flukso/knixx-go/pcb/Knixx_Thunder_00_frontplate_cassini.dxf

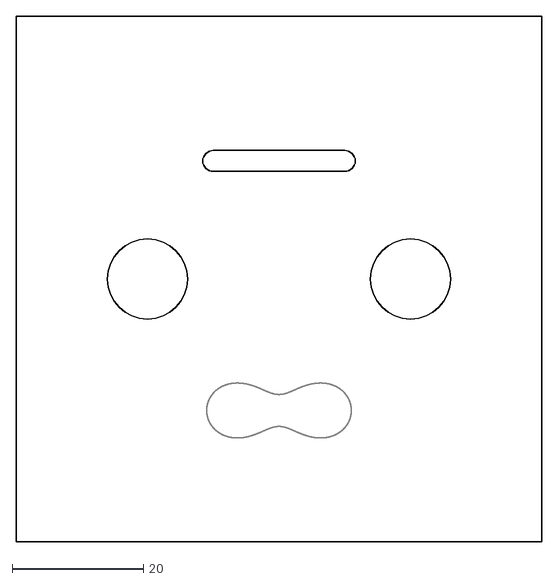
[picture p5: CAD file, 2026-10-24, last stored version]
pcb/Knixx_Thunder_00_frontplate_cassini.dxf
80.0 x 80.0
