flukso/knixx-go/pcb/Knixx_Thunder_00_sampler.dxf

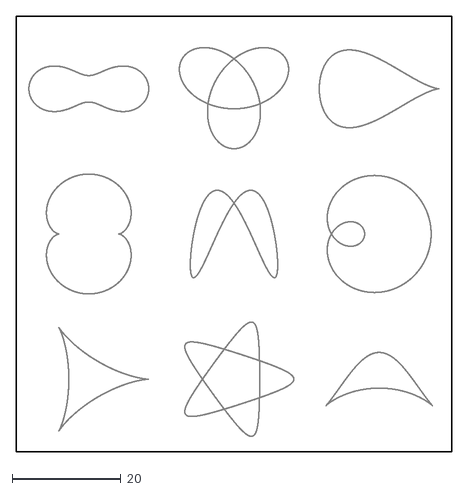
[picture p15: CAD file, 2026-10-24, last stored version]
pcb/Knixx_Thunder_00_sampler.dxf
80.0 x 80.0
