flukso/knixx-go/pcb/Knixx_Thunder_00_frontplate.step

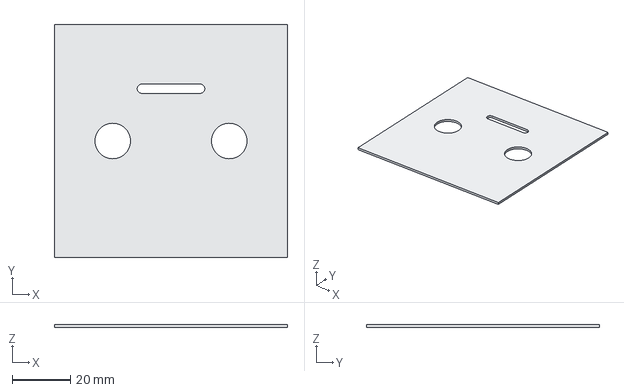
[picture p20: CAD file, 2026-10-23, last stored version]
pcb/Knixx_Thunder_00_frontplate.step
80.0 x 80.0 x 1.00 mm
