flukso/knixx-go/(list of files, cad)

Other CAD files:
pcb/Knixx_Thunder_00_frontplate.dxf
