flukso/knixx-go/(commit log)

2026-10-13 [ftdi|light|config|ncn] ini-configured switches with interactive shell
    Load the device's individual address and the group addresses of
    switches A and B from knixx.ini. An ishell prompt accepts
    "switch <A|B> <on|off>" and queues commands on a buffered channel for a
    separate goroutine that transmits the telegrams. "sniff <on|off>"
    toggles the hex dump of bus traffic, off by default.
    ncn.TxData now returns write errors.
2026-10-14 [ncn|ftdi] stat command and decoding of NCN5121 indications
    Add a "stat" shell command that queries U_State and U_SystemStat and
    prints both decoded. With sniff on, indications in the RX stream
    (L_Data.con, U_State.ind, U_FrameState.ind, U_Reset.ind) are decoded
    below the hex dump; frame octets are skipped so they aren't mistaken for
    services. ncn.TxData now sends a frame in a single write.
2026-10-16 [nrf|bus|cli|config] port the switch to the Feather nRF52840
    Run the KNX switch on the Feather nRF52840 Express. At startup the
    firmware mounts littlefs on the external SPI flash, formatting it and
    writing a default knixx.ini when none is found, and serves the switch,
    sniff and stat commands on a console over USB CDC.
    Code shared by the ftdi and nrf builds moves out of ftdi: bus holds the
    transmit/receive loop, cli the console commands (ishell only wraps them
    on the host), and config parses ini data and embeds the default file.
2026-10-16 [pcb] add knixx Thunder and Thunder Sensor schematics
2026-10-16 [config|cli|bus|nrf] get and set knixx.ini parameters from the console
    Add a "config" command that lists the parameters, gets one, or sets one
    using section.key names (device.individual, A.group, B.group). A valid
    set takes effect immediately and rewrites knixx.ini: on disk for the
    ftdi build, on the littlefs flash for the nrf build.
    The transmit goroutine now works on its own copy of the device, which a
    CmdConfig replaces, and switch commands carry a switch index instead of
    a pointer into the shell's copy.
2026-10-16 [light|config|bus|cli] bind a switch to multiple group addresses
    A.group and B.group accept a comma separated list of up to 8 group
    addresses, in knixx.ini and through "config set". A switch command sends
    one telegram per bound group, each only after the previous one was
    confirmed by L_Data.con or timed out after 500 ms; later commands wait
    until all groups are sent. Negative or missing confirmations are
    reported even with sniff off.
2026-10-16 [lineedit|nrf] command history on the console with the up and down keys
    Move line editing out of the nrf console into a portable lineedit
    package with host tests. It keeps the last 8 lines, browsed with up/down
    (ESC [ A/B, ESC O A/B) or Ctrl-P/N, and swallows other escape sequences
    instead of inserting them into the line.
2026-10-17 [lineedit|tinygo] fix the console locking up while browsing history
    TinyGo 0.42's nRF52840 USB interrupt handler checks IN and OUT completion
    with if/else if. The CDC port uses endpoint 2 for both directions, so an
    OUT that completes in the same interrupt as an IN is never fetched and
    the endpoint NAKs all further input: the console stops responding. A
    history redraw kept IN traffic going for several packets after a key,
    which made the overlap likely.
    - patches/: handle IN and OUT completion independently.
    - Makefile: build against a copy of the system TinyGo root with the
    patches applied (tinygo/root-<version>, selected via TINYGOROOT),
    checking the installed version first.
    - lineedit: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
2026-10-17 [sht2x|thunder|config|bus|nrf] publish SHT20 temperature and humidity on KNX
    tinygo drivers has no SHT2x driver, so add one in internal/sht2x: no hold
    master mode, CRC-8 checked, integer conversion to m°C and c%RH.
    The nrf reads it on I2C1 (SDA P0_12, SCL P0_11; I2C0 shares its
    peripheral with the flash's SPI0) every 60 s from a time.Ticker, which
    TinyGo re-arms at absolute deadlines so the interval does not drift. A
    reading is queued as CmdSensor; the bus goroutine sends it as DPT 9.001
    and DPT 9.007 group value writes, gated on L_Data.con like the switches,
    via a generic per-command write queue. A "sensor" console command shows
    the latest reading.
    The group addresses live in an optional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
2026-10-17 [cli|lineedit] config dump prints the configuration as set commands
    config dump prints one "config set <key> <value>" line per key. Replaying
    them line by line on another knixx reproduces its knixx.ini byte for byte,
    since every set saves config.Format of the whole device and every key,
    including unbound sensor keys as "-", is emitted.
    The console line limit grows from 80 to 128 bytes so that the longest
    dumped line, a switch bound to 8 groups like 31/7/255 (97 bytes), is not
    truncated.
2026-10-17 [tinygo] fix the console hanging when pasting into it
    A paste reaches the USBD as back-to-back OUT packets. When the next packet
    was already pending while the previous OUT DMA had not been handed out, the
    USBD interrupt handler waited for the EasyDMA busy flag with wfi, but only
    a later part of that same handler clears it: the core spun in the ISR
    forever and the whole firmware stopped. IN transfers, started from thread
    mode by the CDC writer, also ignored the flag and could overlap an OUT
    transfer on the single EasyDMA channel.
    The patch serialises all USBD EasyDMA transfers through startDMA, which
    polls the end event of the running transfer instead of sleeping, hands out
    finished OUT tran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
2026-10-18 [vl53l7cx|thunder|config|bus|nrf] publish VL53L7CX motion as KNX occupancy
    Port ST's VL53L7CX ULD 2.0.1 to Go: boot with the embedded firmware,
    4x4 autonomous ranging, the motion indicator and detection thresholds on
    its motion values. The port is checked transaction by transaction
    against the C driver, run on the host against a fake sensor. ST's driver
    sources and licence are kept; the firmware arrays are extracted into
    firmware/*.bin by go generate.
    The sensor pulses INT on frames with motion above the threshold. The
    first motion sends DPT 1.018 occupancy ON, and OFF follows after a
    timeout without motion. A new [occupancy] section configures the group
    address, timeout, threshold, ranging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
2026-10-18 [config] move the sensor groups to [temperature] and [humidity]
    sensor.temperature and sensor.humidity become temperature.group and
    humidity.group, in line with the group key of [A], [B] and [occupancy].
    Each section is left out while its group is unbound. The old [sensor]
    section is no longer read: run config init or set the new keys.
2026-10-18 [doc|pcb] add a README and the MIT and CERN-OHL-P licences
    The README describes the device, the code layout and flow, and every
    configuration parameter with its defaults, limits and dependencies.
    The code is MIT licensed, except for ST's VL53L7CX ULD and the firmware
    extracted from it. The knixx Thunder and Thunder Sensor schematics in
    pcb/ are licensed under the CERN-OHL-P v2.
2026-10-18 [vcnl4040|thunder|config|bus|nrf] publish VCNL4040 illuminance on KNX
    Read the ambient light sensor of the VCNL4040 on I2C1 every minute and
    publish it as DPT 9.004 lux to illuminance.group, 0/1/3 by default. The
    ALS runs at 80 ms integration time: 0 to 6553.5 lx in 0.1 lx steps.
    The ALS has no single measurement mode and draws about 260 µA while on, so
    it is powered on for one measurement of 160 ms and shut down again, also
    after a failed read: under 1 µA on average. The proximity sensor and the
    interrupt stay off. The SHT20 and the VCNL4040 are read and recovered
    independently; the sensor command shows both readings.
2026-10-18 [nrf] fix the flash erase corrupting littlefs and freezing the console
    littlefs takes the 4 KiB sector of flash.Device as its block size, but
    EraseBlocks of tinygo.org/x/drivers v0.36.0 erases a 64 KiB block at
    block × 64 KiB: each erase wiped 16 times the requested area at the wrong
    address, corrupting the filesystem, which was reformatted at the next
    boot. The driver busy-waits for the erase, so the whole firmware froze
    for up to seconds, as seen with repeated config init.
    Wrap the device so that EraseBlocks erases sectors and waits for each one
    while yielding to the other goroutines.
2026-10-18 [led|bus|nrf] show init, occupancy and errors on the WS2812B status LEDs
    A goroutine owns the two WS2812B LEDs on A3 (P0.28); its trigger channel
    is the only way in and senders drop triggers when it is full. Modes are
    queued and played in sequence on LED1: init blinks yellow at 5 Hz until
    the first ToF start (10 s at most), occupancy gives a 50 ms green pulse
    per motion, and errors flash red 10 ms every 100 ms for 0.5 s. LED2
    stays off. bus reports its errors through a new OnError hook.
2026-10-18 [nus|nrf|led|lineedit] add a BLE console on the Nordic UART Service
    "nus on" on the USB console enables the SoftDevice (once; it cannot be
    disabled again), registers NUS, advertises as "knixx" and moves the
    console to BLE. "nus off" drops the central, stops advertising and moves
    the console back to USB; so does 300 s without a connected central, and
    a reset. The HFXO is requested from the SoftDevice so that USB keeps its
    clock.
    Central writes land in a ring from the SoftDevice interrupt; output goes
    out as 20-byte notifications that keep UTF-8 sequences whole and never
    block for long. LED2 pulses blue at 1 Hz while the console is on BLE,
    independently of the LED1 queue. The sensor command p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
2026-10-19 [version|nrf|make] embed the commit and build time in the firmware
    The Makefile sets knixx/version.Commit (the short hash, with -dirty when
    tracked files differ from it) and Date (the build time in UTC) with
    -ldflags -X on every firmware build. The banner shows them below its
    header and the new version command prints the same line. A commit
    rebuilds the DFU package even when no source changed.
2026-10-19 [pcb|readme] add renders of the assembled boards
    Five views (front, back, side, top and bottom) of the 3D model of the
    Thunder and Thunder Sensor boards with the Feather, rendered with a
    transparent background. The README shows the front, back and side views
    below its introduction.
2026-10-19 [render|readme] add the tool that renders the board views
    render/render_step.py reads a STEP assembly with its colours through
    OpenCascade (OCP), meshes it and renders five views off screen with
    PyVista: front, back, side, top and bottom, with a transparent background
    and cropped to the model. make -C render render installs the pinned
    packages in render/.venv once and regenerates the PNGs in pcb/; STEP=
    points at the model, which stays out of the repository.
2026-10-19 [make|tinygo] build with TinyGo 0.43.0 and drop the USB patches
    TinyGo 0.43.0 includes the nRF52840 USB device driver fixes
    (tinygo-org/tinygo#5794) that our two 0.42.0 patches provided: IN and
    OUT completions on the same endpoint are handled independently, and
    every transfer claims the single EasyDMA channel without waiting inside
    the USB interrupt. It also clears EPDATASTATUS before the handlers run,
    which closes a lost-completion race with SoftDevice radio events.
    Without patches for the TinyGo version in patches/, the Makefile now
    builds with the system install directly instead of a copy, and unexports
    TINYGOROOT. The version check runs on every build, as an order-only
    prerequisite. Wit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
2026-10-19 [switches|nrf|cli|nus] drive the switches from the wall toggles
    The two momentary dual-throw wall switches pull D9/D10 (A on/off) and
    A0/A1 (B on/off) low; the inputs use the internal pull-ups. A GPIOTE
    interrupt per contact only counts falling edges. runSwitches polls the
    counts every 20 ms and runs cli.Switch, now shared with the switch
    command, so a press behaves exactly like switch <A|B> <on|off>.
    Holding A on + B off for more than 5 s does nus on, A off + B on does
    nus off; each gesture fires once per hold. The switch goroutine only
    posts the request: the console goroutine, which owns the port, carries
    it out with the code of the nus command (nusStart/nusStop).
    The package switches ho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
2026-10-19 [readme] describe the switches by the wall toggles
    The wall switches are the way to switch the lights; the switch command
    is a debugging aid. Fold the telegram details into the wall switches
    item and drop the separate item for the command.
2026-10-20 [tp1|ncn|bus|config] decode the telegrams on the bus while sniffing
    tp1 gets Unpack, the inverse of Pack, with round-trip tests, and names
    for the priorities and APCIs. The ncn parser collects the standard
    frames it used to skip and reports each as L_DataInd.
    With sniff on, bus decodes every frame, including the echo of its own,
    instead of dumping the raw bytes: source, destination, service, data,
    priority and routing counter. A group bound in the configuration also
    shows its binding, DPT and value. An unbound group gets the DPT of the
    bindings on its main/middle group, when they agree. The lookups use
    tables built on the first decoded frame and dropped on CmdConfig.
    The default sensor and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
2026-10-20 [outq|nrf] never block on the console output
    The TinyGo USB CDC write waits for room in its 512-byte ring while the
    host does not read, which is forever once the cable is pulled with a
    terminal open: the line state that would make it drop the output is
    never reset. With sniff on, the bus loop wrote the trace, hung, and the
    switches stopped working. The NUS writer could also hold a writer for
    up to 1 s per notification.
    All console output now goes into a 2 KiB queue per port (package outq);
    one sender goroutine per port drains it to USB CDC or NUS and is the
    only one that waits. A write that does not fit is dropped whole, and a
    "[N bytes of output dropped]" line marks the gap once the queue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
2026-10-20 [render|pcb|readme] add the front plate STEP and its renders
    render/frontplate.py builds the 1 mm steel front plate from the STEP model
    of the boards: 80 x 80 mm, Ø12.2 mm holes on the toggle switch bushings,
    and a 23 x 3 mm slot with rounded ends centred on the VL53L7CX. The
    plate's underside sits 3 mm above the switch bodies. The script also
    writes the boards with the plate, with the sensor board's underside moved
    to 12 mm above the main board. make -C render frontplate runs it.
    The plate STEP and the renders of the assembly are added; the STEP models
    of the boards stay out of the repository.
    [Knixx_Thunder_00_frontplate.step]
2026-10-20 [render|pcb|readme] add the DXF of the front plate
    frontplate.py now also writes the plate's outline for cutting: the edges
    of its top face as R12 DXF lines, circles and arcs, in mm, with the
    plate's lower-left corner at the origin. make -C render frontplate
    builds it with the STEP files.
    [Knixx_Thunder_00_frontplate.dxf]
2026-10-20 [render] make the venv with a Python that has the cadquery-ocp wheels
    cadquery-ocp ships wheels for Python 3.11 to 3.14 only, so pip found
    nothing when python3 was 3.15. Take the newest of those that is
    installed, overridable with PY=, and remove a stale venv first.
2026-10-20 [nusterm|blescan|ota|readme] add a terminal for the BLE console
    nusterm connects to the BLE console (NUS) of a board with the computer's
    own Bluetooth adapter, through tinygo.org/x/bluetooth: BlueZ on Linux,
    CoreBluetooth on macOS. The terminal runs in raw mode, so keys go to the
    board's line editor as on USB; Ctrl-] quits. It sends a CR on connecting
    to bring up the banner and prompt, writes with response so that a paste
    cannot overflow the board's receive ring, and exits on a disconnect.
    make nus runs it.
    The scan for an advertiser by name or address moves from ota to
    internal/blescan, which both tools use.
2026-10-20 [lineedit|readme] hold console lines of up to 255 characters
    MaxLine goes from 128 to 255, the most the editor's uint8 lengths hold,
    so that longer pasted lines are not cut. The editor takes 1.4 KB more
    RAM.
2026-10-20 [readme] make ota works on macOS too
    Tested from a Mac: make ota finds the bootloader through CoreBluetooth,
    as make nus does, and sends the package. ADDR= is then the UUID that
    macOS gives the bootloader, not the board's MAC address plus one.
2026-10-21 [cad|readme] rename render to cad
    The directory holds the front plate tool next to the renderer, so cad
    names it better. make -C cad render and make -C cad frontplate replace
    the make -C render forms, and the venv moves to cad/.venv.
2026-10-21 [bolt|ota|nusterm|blescan|make|readme] unify ota and nusterm into bolt
    One host tool for a board over BLE, bolt, replaces ota and nusterm:
    bolt ota sends a DFU package to the bootloader and bolt term is the
    terminal on the BLE console, with the same flags as before. Both share
    the adapter setup and the scan. bolt ota prints its status to stderr,
    as term does. make bolt builds build/bolt; make ota and make nus run it.
2026-10-21 [bus|ncn|tp1] render the sniffer trace without heap allocations
2026-10-21 [bus|tp1|ncn|cli|led|lineedit|vl53l7cx|make|readme|claude] keep the steady state free of heap allocations
    Send telegrams from fixed buffers (tp1 PackTo, ncn TxData with a caller
    buffer, DPT values packed from integer hundredths), keep the switch name
    from escaping in cli.Switch, echo keys from the editor's buffer, and play
    the LEDs without re-arming a time.Timer, which allocates in TinyGo.
    make allocs (part of make test) checks the calls from the firmware's code
    that reach runtime.alloc, from its disassembly, against allocs.txt; the
    188 accepted calls are startup, configuration, console commands and error
    paths. CLAUDE.md gets the rule.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
2026-10-21 [make|readme] accept a failed flash on macOS when the board runs the new build
2026-10-21 [bolt|uf2|usbserial|make|readme] flash over USB with bolt uf2 instead of tinygo flash
    bolt uf2 carries over the UF2 procedure of tinygo flash: it checks the UF2
    file, resets the board into its bootloader with a 1200 baud touch, copies
    the file to the FTHR840BOOT drive, and passes once the board's version
    command prints the expected build. The expected write error after the
    bootloader's reset no longer fails the flash, so tools/flashcheck.sh goes.
2026-10-21 [bolt|uf2|readme] mount the bootloader's drive through udisks
    Without an automounter, as in a window manager session with no desktop
    environment, nothing mounts the FTHR840BOOT drive, and bolt uf2 waited
    for it until its timeout. On Linux bolt uf2 now asks udisks2 over the
    system D-Bus to mount the FAT drive with that label, as udisksctl mount
    or a file manager does, when it is there but not mounted. polkit allows
    the mount for the user at the machine; a refusal is reported once, and
    bolt keeps waiting for a mount by hand.
    godbus/dbus/v5, already in the module graph through tinygo bluetooth,
    becomes a direct requirement at the same version.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
2026-10-21 [make|allocs|readme] disassemble the firmware with llvm-objdump
    make allocs ran plain objdump, which is LLVM's on macOS but GNU binutils
    for the host on Linux: it cannot disassemble the ARM firmware, and even
    arm-none-eabi-objdump prints calls in a form tools/allocs does not
    parse, so make test failed on Linux. OBJDUMP now defaults to llvm-objdump
    in the PATH, else the newest versioned llvm-objdump-NN as Debian installs
    it, else objdump; it can be overridden. tools/allocs names llvm-objdump
    when it finds no calls.
2026-10-21 [make|readme] make libftdi optional in make test, fix the README's requirements
    make test leaves src/ftdi out when pkg-config does not find libftdi1. The
    patched TinyGo copy starts from tinygo env TINYGOROOT, not a fixed path.
    README: the requirements are split into required and optional; nrfutil
    only builds the DFU package, which bolt ota sends; a C compiler is needed
    on macOS for bolt (CoreBluetooth through cgo); LLVM's objdump for make
    allocs; no TinyGo install path. Also the macOS console port, the commands
    of the FTDI build, make flash checking the version, and the Go
    dependencies.
2026-10-21 [bolt|legacydfu|make|readme] build the DFU package with bolt genpkg instead of adafruit-nrfutil
    bolt genpkg turns the application's hex file into the DFU package as
    adafruit-nrfutil dfu genpkg does: legacydfu reads the Intel HEX into one
    image (0xFF in the gaps, the MBR and UICR left out, padded to 4 bytes),
    builds the init packet with its CRC-16/CCITT-FALSE and writes the zip
    with the same manifest.json. On build/knixx.hex its knixx.bin, knixx.dat
    and manifest.json are byte-identical to nrfutil's. make dfu runs it, with
    bolt as an order-only prerequisite, so make dfu and make ota need no
    Python tool any more. Tested with make ota on the board.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
2026-10-21 [bolt|usbserial|make|readme] bolt term on the USB console too, with make term
    bolt term [-usb|-ble] connects to the console on the USB serial port or on
    BLE NUS. Without a flag it sends a CR on the knixx USB port and takes USB
    when the board answers within 500 ms; after nus on the port stays silent,
    and without a USB port there is none, so it takes BLE. -port implies USB,
    -addr BLE. The session loop is shared by both transports; the USB port is
    opened exclusively (TIOCEXCL), so another program finds it busy. make term
    runs it, make nus runs bolt term -ble. The README drops screen for make
    term. Tested on macOS: USB, the fallback to BLE after nus on, and a busy
    port.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
2026-10-23 [cad|readme] widen the front plate's slot to 3.2 mm
    The slot over the VL53L7CX is 3.2 mm wide instead of 3 mm, still centred
    on it; with the rounded ends 20 mm apart it is 23.2 mm long. The plate's
    STEP and DXF are regenerated. Also names the sensor right in the comment.
    [Knixx_Thunder_00_frontplate.dxf, Knixx_Thunder_00_frontplate.step]
2026-10-24 [cad|readme] engrave 14 curves on front plate DXFs, plus a 3x3 sampler
    The plain front plate DXF stays without engraving. Each of the 14 curves
    gets its own DXF, as one closed polyline on layer ENGRAVE, centred in X a
    quarter up the plate at an 11 mm radius. The sampler DXF puts nine of them
    in a 3 x 3 grid on a plain 80 x 80 mm square. The plate's STEP, and with it
    the assembly, has no engraving.
    [Knixx_Thunder_00_frontplate_astroid.dxf, Knixx_Thunder_00_frontplate_bicorn.dxf, Knixx_Thunder_00_frontplate_cardioid.dxf, Knixx_Thunder_00_frontplate_cassini.dxf, Knixx_Thunder_00_frontplate_deltoid.dxf, Knixx_Thunder_00_frontplate_fish.dxf, Knixx_Thunder_00_frontplate_hypotrochoid.dxf, Knixx_Thunder_00_frontplate_lemniscate.dxf]
2026-10-24 [cad|readme] draw the sampler as a grey PNG with a transparent background, shown in the README
2026-10-27 [tinygo|make|readme] patch the lost wakeup in TinyGo's nRF rtc_sleep that froze the board
    The board froze after 2h26m36s of uptime (2^43 ns), every time: no
    console, no LEDs, no sensors, while interrupts still ran. TinyGo 0.43.0's
    rtc_sleep enabled the RTC COMPARE0 interrupt before it cleared rtc_wakeup.
    With a compare event pending from an earlier short sleep, the handler ran
    in between, set rtc_wakeup and disabled the interrupt; rtc_sleep then
    cleared rtc_wakeup and waited for good, and with the scheduler every
    goroutine stopped. A probe on a frozen board showed the CPU in that wait
    loop with COMPARE0 disabled and CC behind COUNTER.
    The patch clears the flag and a stale event first and en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
2026-10-27 [i2cbus|nrf|readme] share I2C1 between the sensor and ToF goroutines, one transfer at a time
    The SHT20 and VCNL4040 (sensor goroutine) and the VL53L7CX (ToF goroutine)
    share I2C1. TinyGo's nRF52 I2C transfer yields to the scheduler while it
    waits, so a motion read could start on the peripheral in the middle of a
    sensor read, reprogramming it under the running transfer. i2cbus.Shared
    holds a mutex for each transfer; the drivers go through it. Host tests
    check that yielding transfers no longer overlap and that Tx does not
    allocate.
2026-10-27 [cad|readme] write the CAD outputs to build/cad/, make the front plate without the board model
    frontplate.py builds the plate from its own dimensions, with the slot at
    SLOT_OFFSET (17.955 mm, as measured on the model) above the switch axes,
    in the plate's frame. The plate STEP, the DXFs and the sampler no longer
    need the board model. With the model present, the plate is first checked
    against it (switch spacing, VL53L7CX position) and the assembly STEP is
    written too; a mismatch stops it before it writes anything.
    All outputs go to build/cad/ and leave the repository, except the four
    PNGs that the README shows, moved to docs/img/; make -C cad readme
    refreshes them. Stamp files replace the gr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
    [Knixx_Thunder_00_frontplate.dxf, Knixx_Thunder_00_frontplate.step, Knixx_Thunder_00_frontplate_astroid.dxf, Knixx_Thunder_00_frontplate_bicorn.dxf, Knixx_Thunder_00_frontplate_cardioid.dxf, Knixx_Thunder_00_frontplate_cassini.dxf, Knixx_Thunder_00_frontplate_deltoid.dxf, Knixx_Thunder_00_frontplate_fish.dxf]
2026-11-03 [plan] the plans of the host tools and the console work
    The plans that the work of 2026-10-20 and 2026-10-21 followed, kept for
    reference, each marked completed with the commit that implemented it:
    checking the BLE terminal and ota on macOS, moving the BLE host tools to
    src/host, unifying ota and nusterm into bolt, the overnight USB console
    hang, the sniffer without heap allocations, bolt uf2, bolt genpkg and bolt
    term over USB and BLE. They were recovered from the planning session's
    transcript, which reused one plan file for all of them.
2026-11-09 [plan] the plans of the work from 2026-10-13 to 2026-10-21
    The plans that the work of 2026-10-13 to 2026-10-21 on this computer
    followed, kept for reference next to those of 5de429a: from the
    ini-configured switches and the port to the Feather nRF52840, through
    the config commands, the sensors, the status LEDs, the BLE console and
    OTA, to the front plate, the BLE terminal and the udisks mount of bolt
    uf2. Each is marked completed with the commit that implemented it, or
    not implemented with the reason, and a revised plan quotes the feedback
    that turned back its earlier version.
    They were recovered from the planning session's transcript, which
    reused one plan file for all of them. Three were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
